MichaelBell/tt-ecp5-bb/README.md

# ECP5 breakout board for Tiny Tapeout Carrier



A super minimal breakout, for prototyping Tiny Tapeout designs on an ECP5 FPGA.
