MichaelBell/tt-ecp5-bb/tt-ecp5-cb.pdf

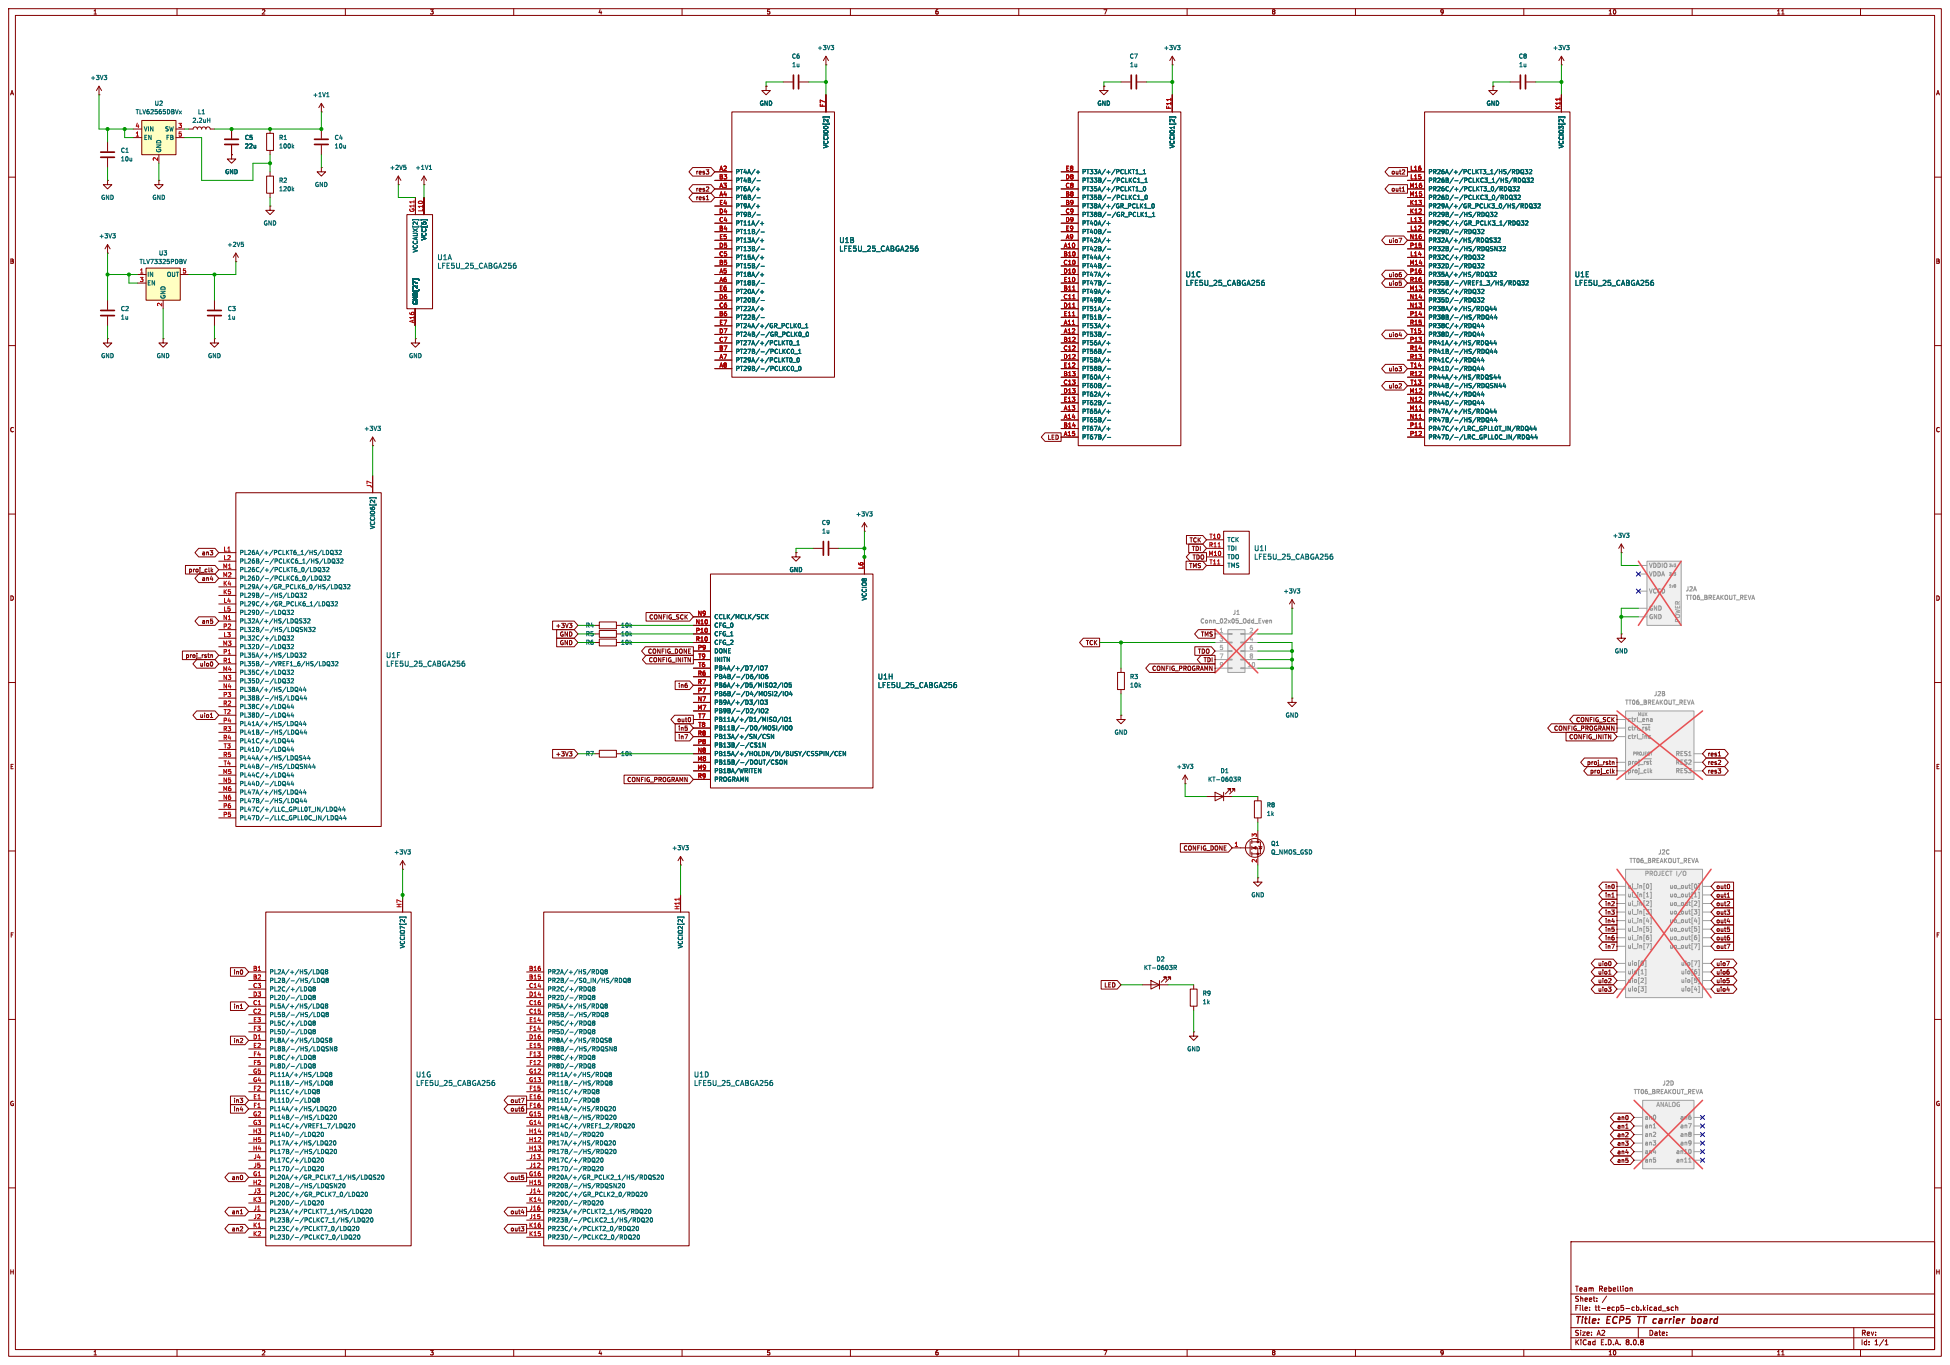
[picture p1: page 1]
