MichaelBell/tt-ecp5-bb/tt-ecp5-cb.kicad_pcb

## KiCad design tt-ecp5-cb.kicad_pcb (2025-03-09)

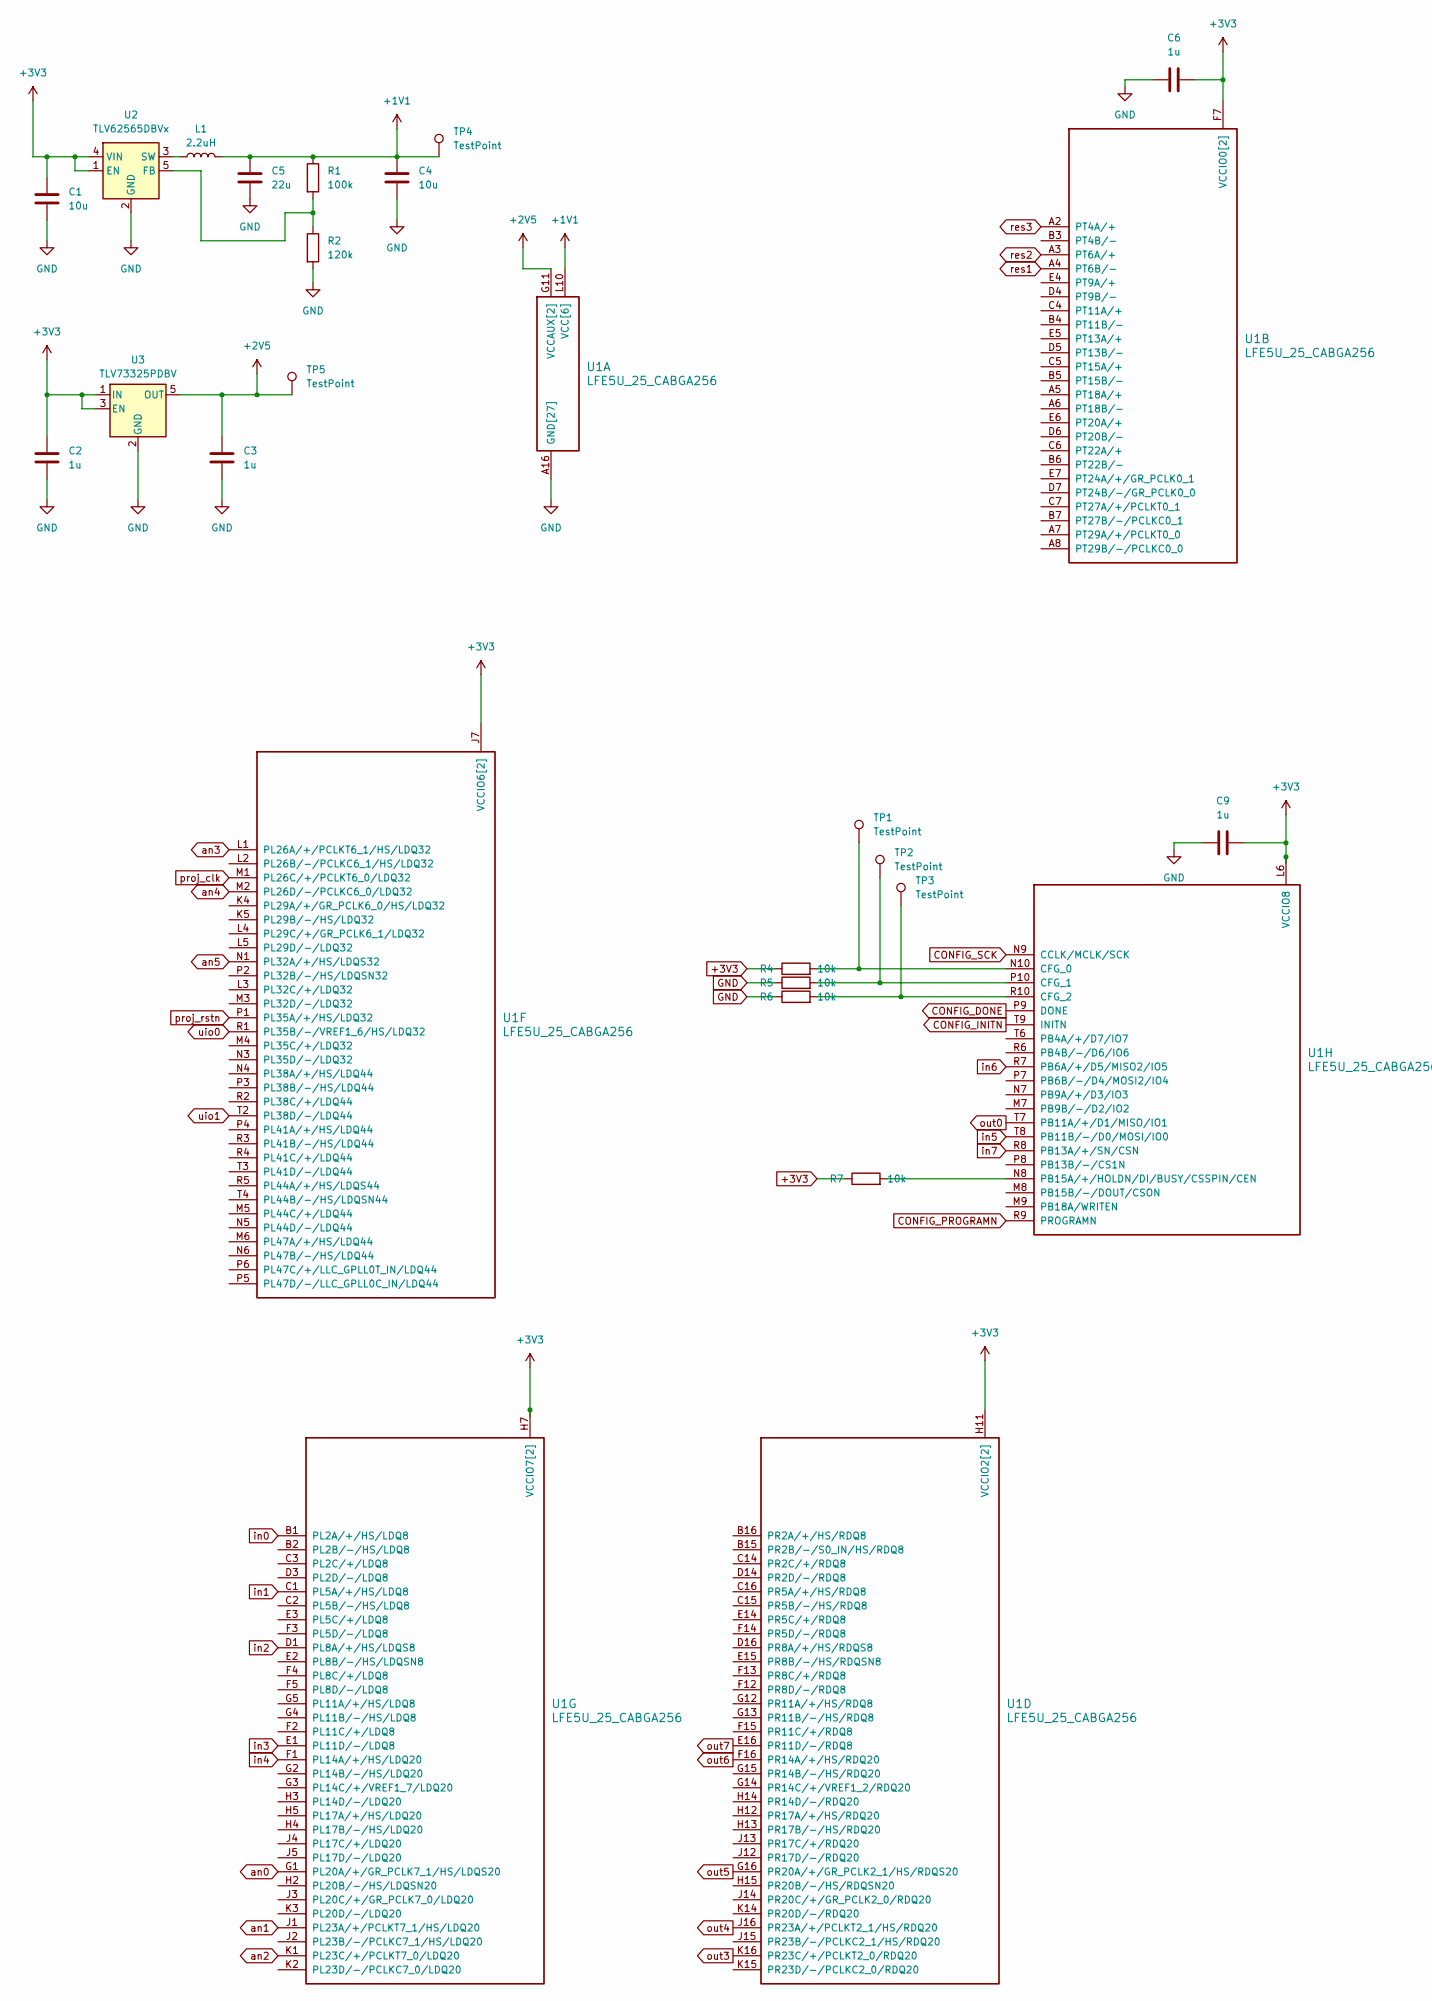
[picture p2: schematic tt-ecp5-cb.kicad_sch, ECP5 TT carrier board, part in row 1, column 1]

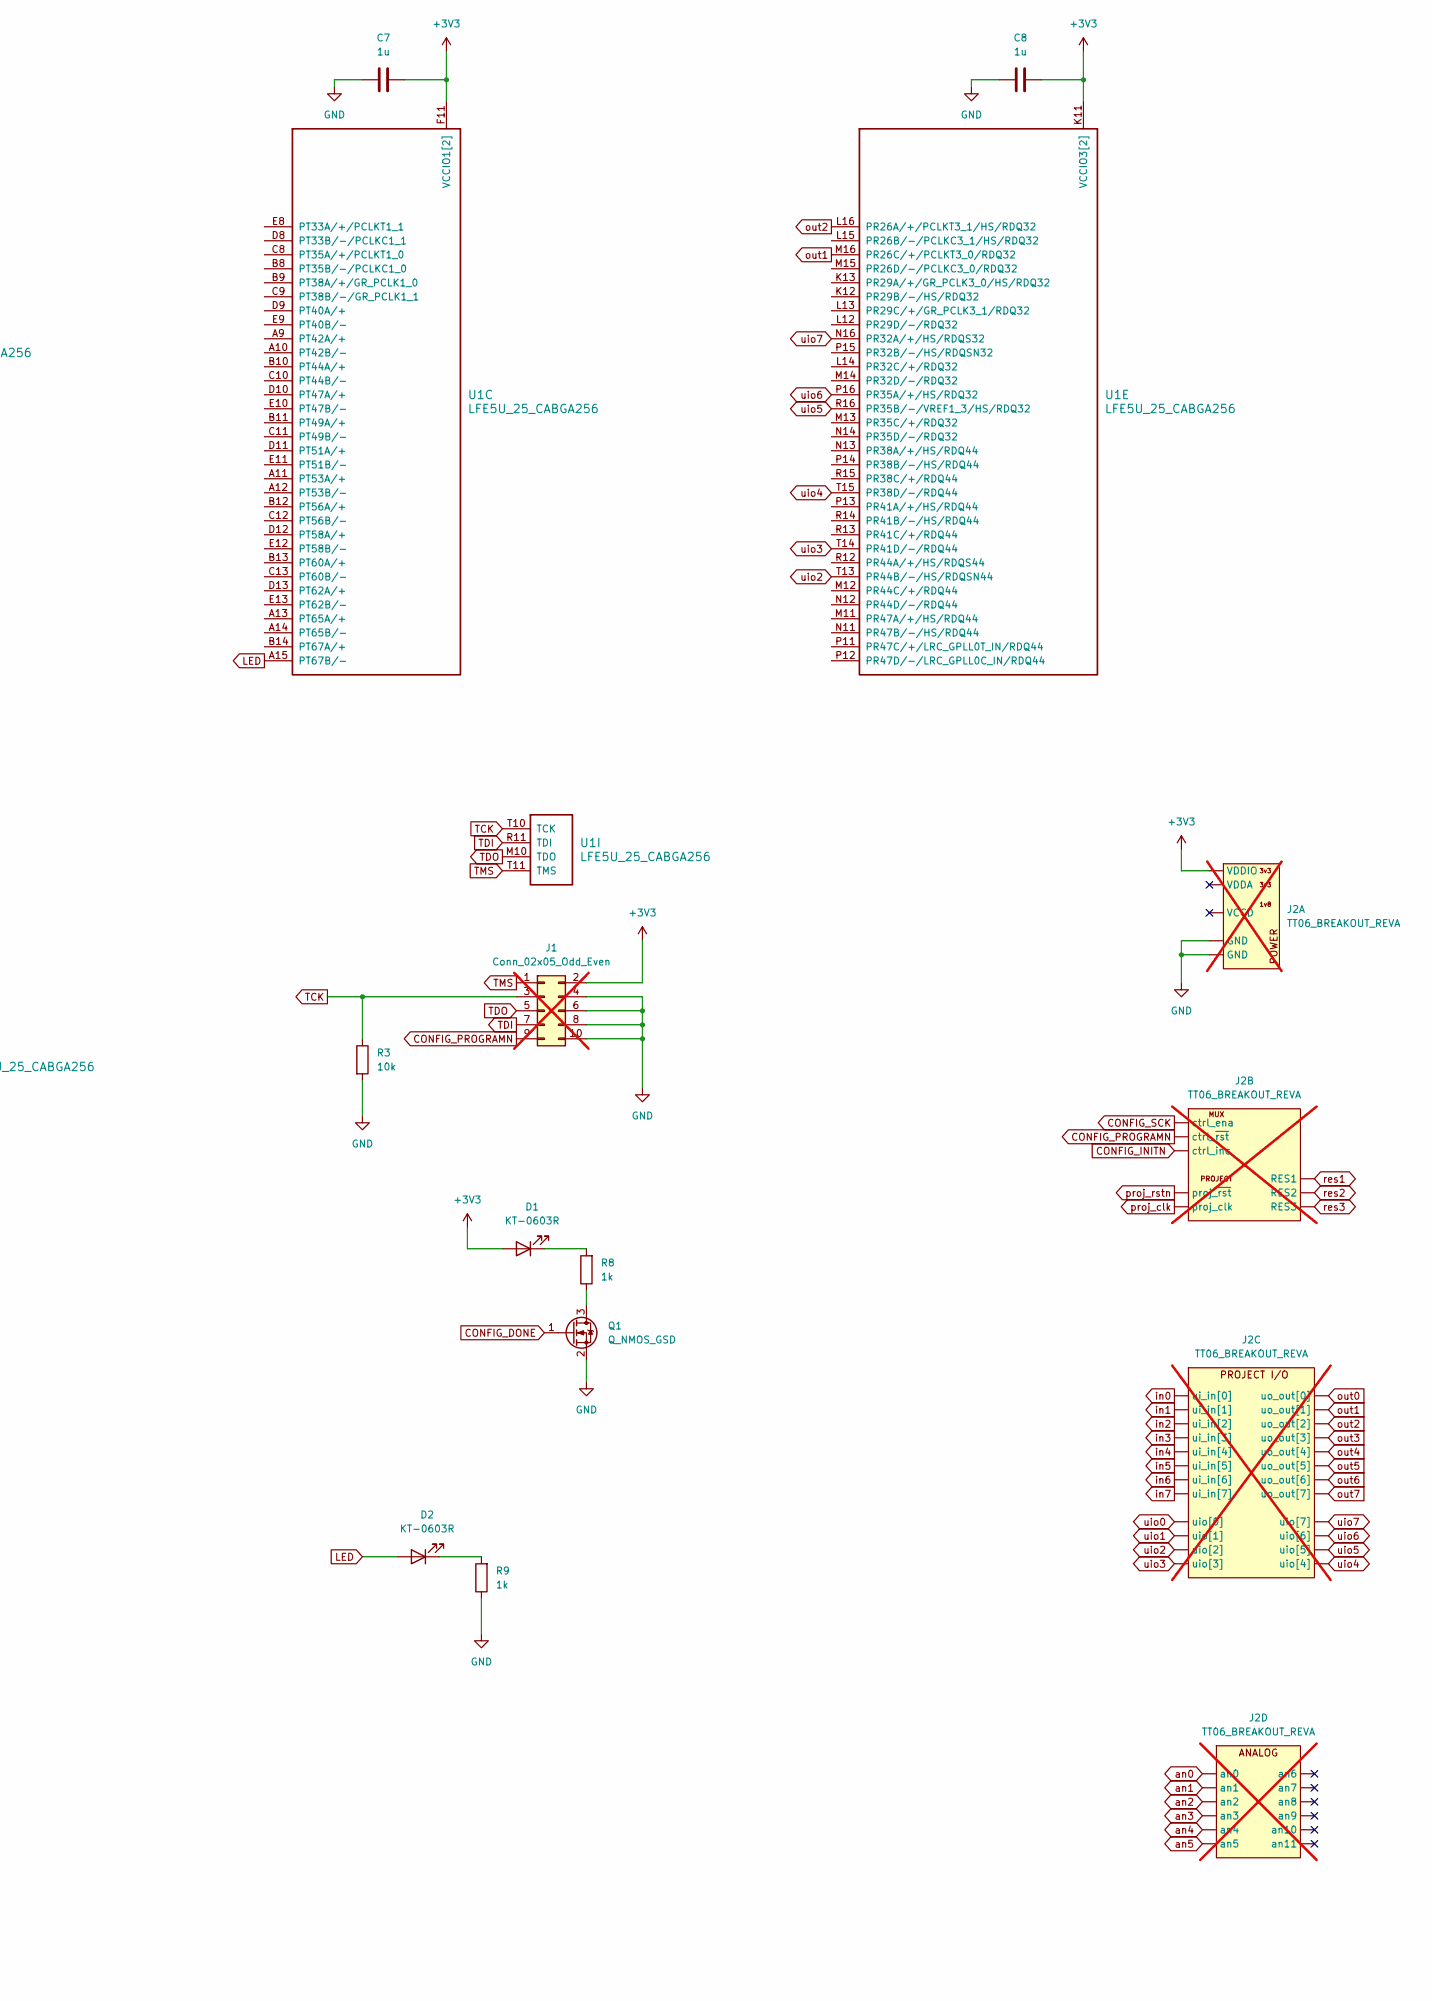
[picture p3: schematic tt-ecp5-cb.kicad_sch, ECP5 TT carrier board, part in row 1, column 2]

Parts:
C1, C4: 10u; C_0402_1005Metric
C2, C3, C6, C7, C8, C9: 1u; C_0402_1005Metric
C5: 22u; C_0603_1608Metric
D1, D2: KT-0603R; LED_0603_1608Metric; JLC C2286
J1: Conn_02x05_Odd_Even; PinHeader_2x05_P2.54mm_Vertical; not fitted
J2: TT06_BREAKOUT_REVA; TT06_CARRIER_ON_DB; not fitted
L1: 2.2uH; L_0805_2012Metric; JLC C281115
Q1: Q_NMOS_GSD; SOT-23; JLC C8545
R1: 100k; R_0402_1005Metric
R2: 120k; R_0603_1608Metric
R3, R4, R5, R6, R7: 10k; R_0603_1608Metric
R8, R9: 1k; R_0402_1005Metric
TP1, TP2, TP3, TP4, TP5: TestPoint; TestPoint_Pad_2.0x2.0mm
U1: LFE5U_25_CABGA256; CABGA-256_L14.0-W14.0-R16-C16-P0.80-TL; JLC C1521614
U2: TLV62565DBVx; SOT-23-5; JLC C87122
U3: TLV73325PDBV; SOT-23-5; JLC C882825

Connections:
+1V1: C4.1, C5.1, L1.2, R1.1, TP4.1, U1.G6 (VCC[6]), U1.G7 (VCC[6]), U1.G9 (VCC[6]), U1.L8 (VCC[6]), U1.L9 (VCC[6]), U1.L10 (VCC[6])
+2V5: C3.1, TP5.1, U1.G11 (VCCAUX[2]), U1.L7 (VCCAUX[2]), U3.5 (OUT)
+3V3: C1.1, C2.1, C6.2, C7.2, C8.2, C9.2, D1.2 (A), J1.2, J2.B4 (VDDIO), R4.1, R7.1, U1.F6 (VCCIO0[2]), U1.F7 (VCCIO0[2]), U1.F10 (VCCIO1[2]), U1.F11 (VCCIO1[2]), U1.H6 (VCCIO7[2]), U1.H7 (VCCIO7[2]), U1.H11 (VCCIO2[2]), U1.J6 (VCCIO6[2]), U1.J7 (VCCIO6[2]), U1.J11 (VCCIO2[2]), U1.K11 (VCCIO3[2]), U1.L6 (VCCIO8), U1.L11 (VCCIO3[2]), U2.1 (EN), U2.4 (VIN), U3.1 (IN), U3.3 (EN)
CONFIG_DONE: Q1.1 (G), U1.P9 (DONE)
CONFIG_INITN: J2.A3 (ctrl_inc), U1.T9 (INITN)
CONFIG_PROGRAMN: J1.9, J2.A4 (ctrl_~rst), U1.R9 (PROGRAMN)
CONFIG_SCK: J2.A2 (ctrl_ena), U1.N9 (CCLK/MCLK/SCK)
GND: C1.2, C2.2, C3.2, C4.2, C5.2, C6.1, C7.1, C8.1, C9.1, J1.4, J1.6, J1.8, J1.10, J2.A1 (GND), J2.A5 (GND), J2.A12 (GND), J2.A15 (GND), J2.A18 (GND), J2.A21 (GND), J2.A23 (GND), J2.A25 (GND), J2.A27 (GND), J2.A29 (GND), J2.A31 (GND), J2.A32 (GND), J2.A33 (GND), J2.A37 (GND), J2.A38 (GND), J2.B1 (GND), J2.B3 (GND), J2.B6 (GND), J2.B8 (GND), J2.B10 (GND), J2.B12 (GND), J2.B14 (GND), J2.B16 (GND), J2.B17 (GND), J2.B18 (GND), J2.B23 (GND), J2.B24 (GND), J2.B29 (GND), J2.B30 (GND), J2.B35 (GND), J2.B36 (GND), J2.B39 (GND), J2.B40 (GND), Q1.2 (S), R2.2, R3.2, R5.1, R6.1, R9.1, U1.A1 (GND[27]), U1.A16 (GND[27]), U1.D2 (GND[27]), U1.D15 (GND[27]), U1.F8 (GND[27]), U1.F9 (GND[27]), U1.G8 (GND[27]), U1.G10 (GND[27]), U1.H1 (GND[27]), U1.H8 (GND[27]), U1.H9 (GND[27]), U1.H10 (GND[27]), U1.H16 (GND[27]), U1.J8 (GND[27]), U1.J9 (GND[27]), U1.J10 (GND[27]), U1.K6 (GND[27]), U1.K7 (GND[27]), U1.K8 (GND[27]), U1.K9 (GND[27]), U1.K10 (GND[27]), U1.N2 (GND[27]), U1.N15 (GND[27]), U1.T1 (GND[27]), U1.T5 (GND[27]), U1.T12 (GND[27]), U1.T16 (GND[27]), U2.2 (GND), U3.2 (GND)
LED: D2.2 (A), U1.A15 (PT67B/-)
unnamed: D1.1 (K), R8.2
unnamed: D2.1 (K), R9.2
unnamed: Q1.3 (D), R8.1
unnamed: R4.2, TP1.1, U1.N10 (CFG_0)
unnamed: R5.2, TP2.1, U1.P10 (CFG_1)
unnamed: R6.2, TP3.1, U1.R10 (CFG_2)
unnamed: R7.2, U1.N8 (PB15A/+/HOLDN/DI/BUSY/CSSPIN/CEN)
unnamed: R1.2, R2.1, U2.5 (FB)
unnamed: L1.1, U2.3 (SW)
TCK: J1.3, R3.1, U1.T10 (TCK)
TDI: J1.7, U1.R11 (TDI)
TDO: J1.5, U1.M10 (TDO)
TMS: J1.1, U1.T11 (TMS)
an0: J2.A20 (an0), U1.G1 (PL20A/+/GR_PCLK7_1/HS/LDQS20)
an1: J2.A22 (an1), U1.J1 (PL23A/+/PCLKT7_1/HS/LDQ20)
an2: J2.A24 (an2), U1.K1 (PL23C/+/PCLKT7_0/LDQ20)
an3: J2.A26 (an3), U1.L1 (PL26A/+/PCLKT6_1/HS/LDQ32)
an4: J2.A28 (an4), U1.M2 (PL26D/-/PCLKC6_0/LDQ32)
an5: J2.A30 (an5), U1.N1 (PL32A/+/HS/LDQS32)
in0: J2.A9 (ui_in[0]), U1.B1 (PL2A/+/HS/LDQ8)
in1: J2.A11 (ui_in[1]), U1.C1 (PL5A/+/HS/LDQ8)
in2: J2.A14 (ui_in[2]), U1.D1 (PL8A/+/HS/LDQS8)
in3: J2.A13 (ui_in[3]), U1.E1 (PL11D/-/LDQ8)
in4: J2.A17 (ui_in[4]), U1.F1 (PL14A/+/HS/LDQ20)
in5: J2.A19 (ui_in[5]), U1.T8 (PB11B/-/D0/MOSI/IO0)
in6: J2.A16 (ui_in[6]), U1.R7 (PB6A/+/D5/MISO2/IO5)
in7: J2.A34 (ui_in[7]), U1.R8 (PB13A/+/SN/CSN)
out0: J2.B27 (uo_out[0]), U1.T7 (PB11A/+/D1/MISO/IO1)
out1: J2.B28 (uo_out[1]), U1.M16 (PR26C/+/PCLKT3_0/RDQ32)
out2: J2.B25 (uo_out[2]), U1.L16 (PR26A/+/PCLKT3_1/HS/RDQ32)
out3: J2.B26 (uo_out[3]), U1.K16 (PR23C/+/PCLKT2_0/RDQ20)
out4: J2.B21 (uo_out[4]), U1.J16 (PR23A/+/PCLKT2_1/HS/RDQ20)
out5: J2.B22 (uo_out[5]), U1.G16 (PR20A/+/GR_PCLK2_1/HS/RDQS20)
out6: J2.B19 (uo_out[6]), U1.F16 (PR14A/+/HS/RDQ20)
out7: J2.B20 (uo_out[7]), U1.E16 (PR11D/-/RDQ8)
proj_clk: J2.A35 (proj_clk), U1.M1 (PL26C/+/PCLKT6_0/LDQ32)
proj_rstn: J2.A36 (proj_~rst), U1.P1 (PL35A/+/HS/LDQ32)
res1: J2.A6 (RES1), U1.A4 (PT6B/-)
res2: J2.A8 (RES2), U1.A3 (PT6A/+)
res3: J2.A10 (RES3), U1.A2 (PT4A/+)
uio0: J2.A39 (uio[0]), U1.R1 (PL35B/-/VREF1_6/HS/LDQ32)
uio1: J2.A40 (uio[1]), U1.T2 (PL38D/-/LDQ44)
uio2: J2.B37 (uio[2]), U1.T13 (PR44B/-/HS/RDQSN44)
uio3: J2.B38 (uio[3]), U1.T14 (PR41D/-/RDQ44)
uio4: J2.B33 (uio[4]), U1.T15 (PR38D/-/RDQ44)
uio5: J2.B34 (uio[5]), U1.R16 (PR35B/-/VREF1_3/HS/RDQ32)
uio6: J2.B31 (uio[6]), U1.P16 (PR35A/+/HS/RDQ32)
uio7: J2.B32 (uio[7]), U1.N16 (PR32A/+/HS/RDQS32)

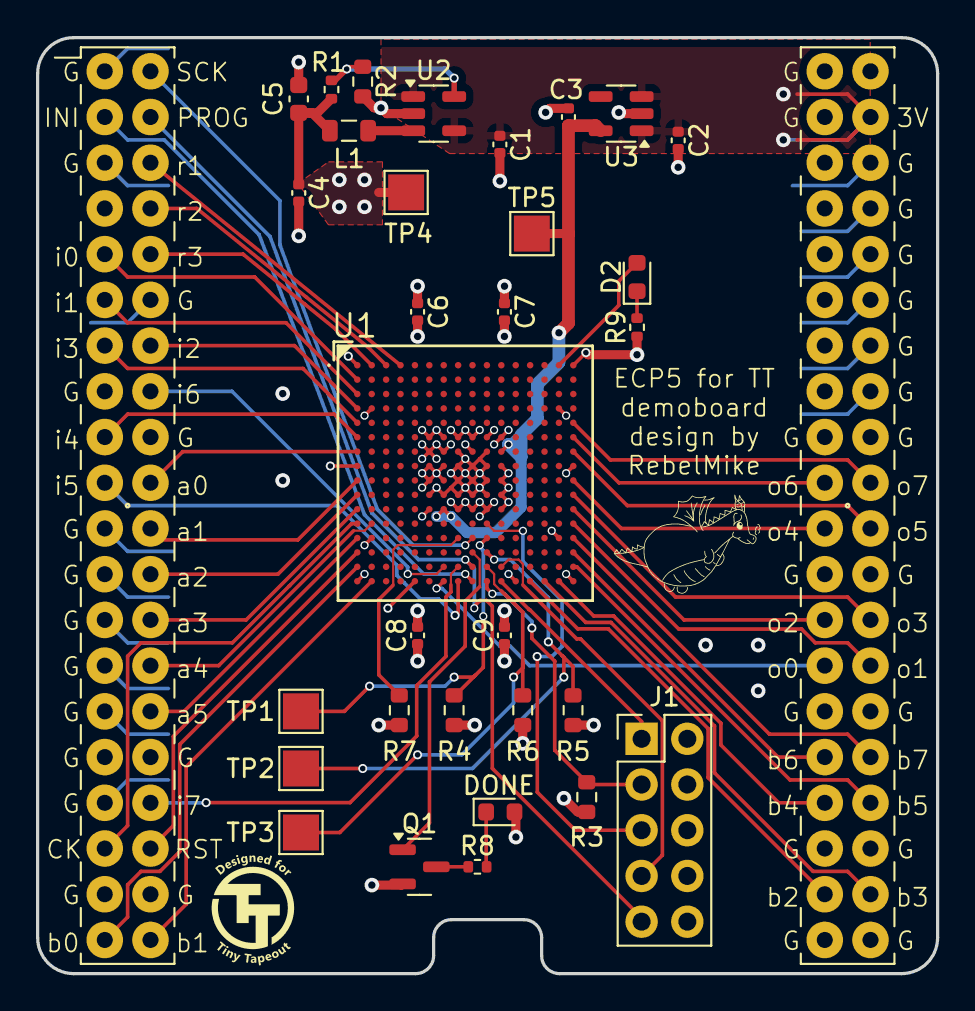
[picture p4: board tt-ecp5-cb.kicad_pcb from above]

Board: 4 copper layers, 50.0 x 52.0 mm, 32 parts (0 on the bottom side), 57 nets.
