MichaelBell/tt-ecp5-bb/(commit log)

2025-03-08 Silkscreen, test pads
    [tt-ecp5-cb.kicad_pcb, tt-ecp5-cb.kicad_sch]
2025-03-09 First version
    [tt-ecp5-cb.kicad_pcb, tt-ecp5-cb.kicad_sch]
2025-03-21 ECP programming from TT demo board
